systembolaget/Physical-computing-sensor-LED-tutorial-3b-LED-inclinometer-with-Analog-Devices-ADXL345/Assets/3b calibration.png

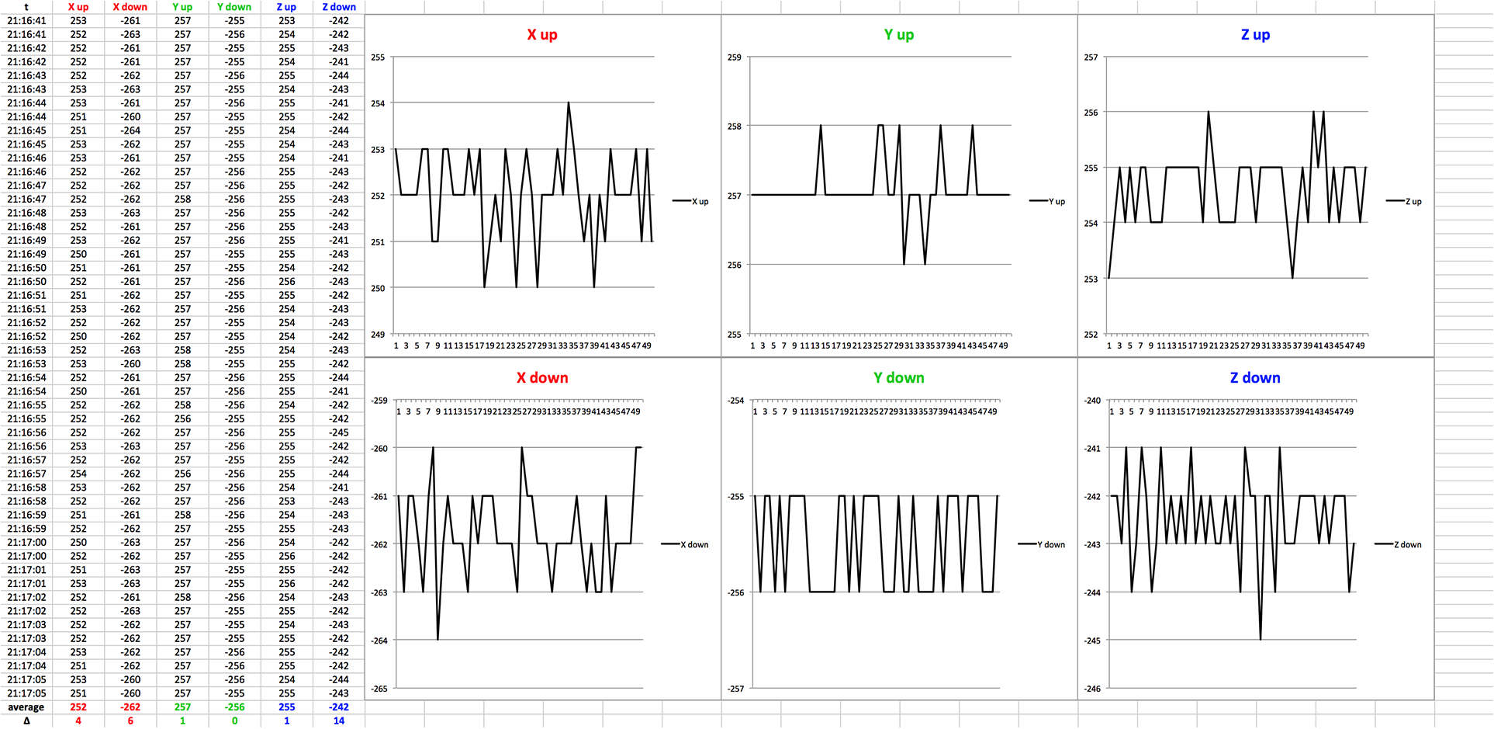
Assets/3b calibration.png
